Hammie217/OpenSourcePSU/Images/3D.PNG

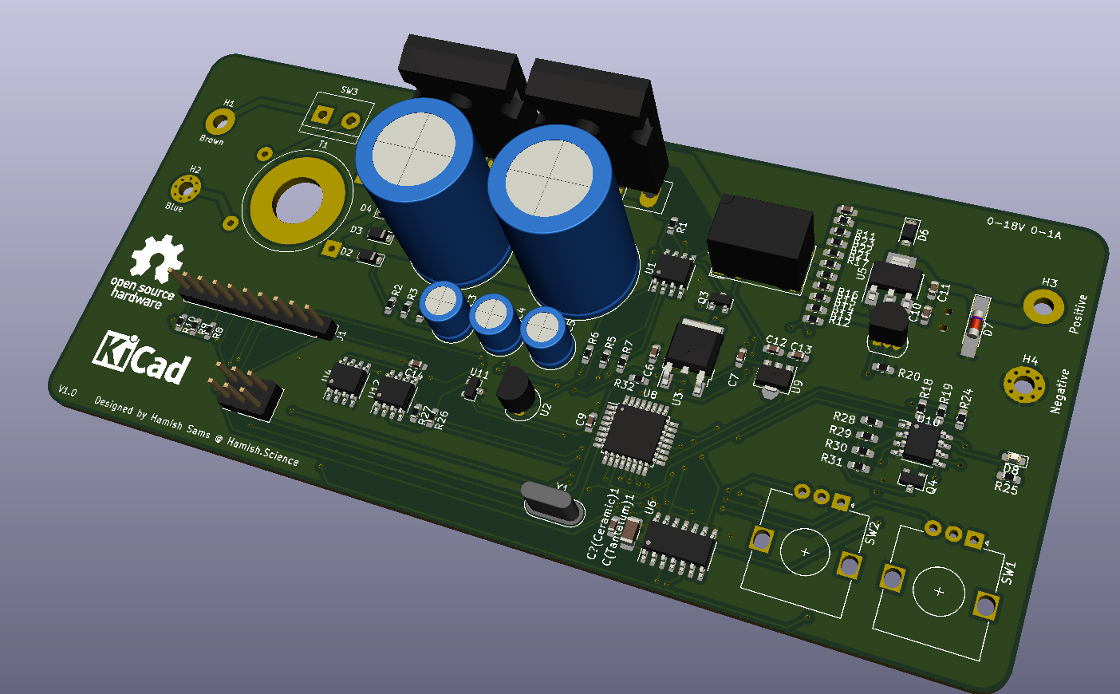
Images/3D.PNG
