Hammie217/OpenSourcePSU/Images/3DBackV2.PNG

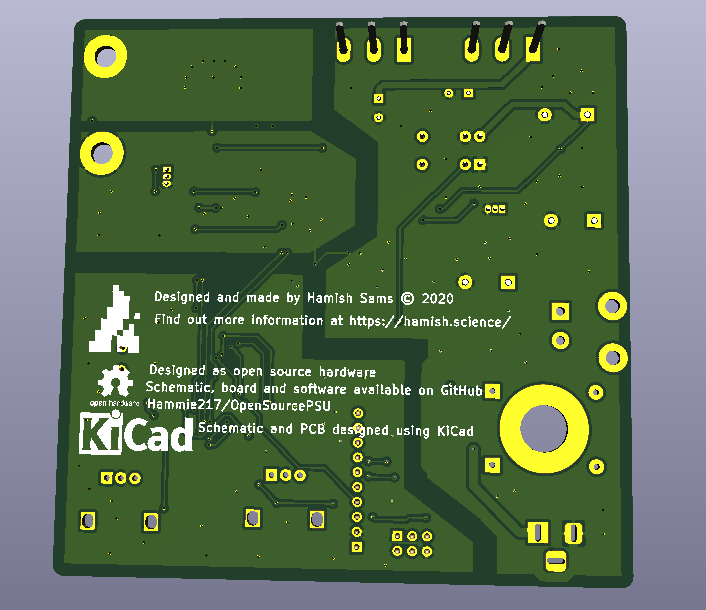
Images/3DBackV2.PNG
