Hammie217/OpenSourcePSU/Images/3DV2.PNG

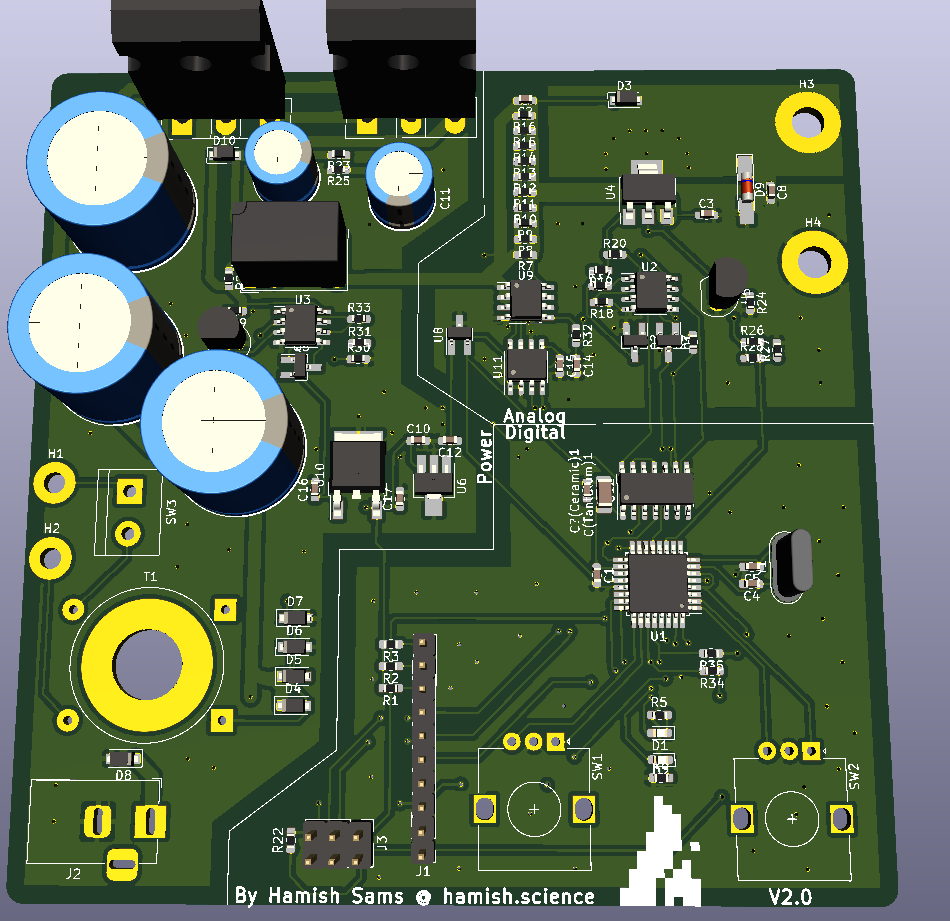
Images/3DV2.PNG
