Hammie217/OpenSourcePSU/Images/Both.PNG

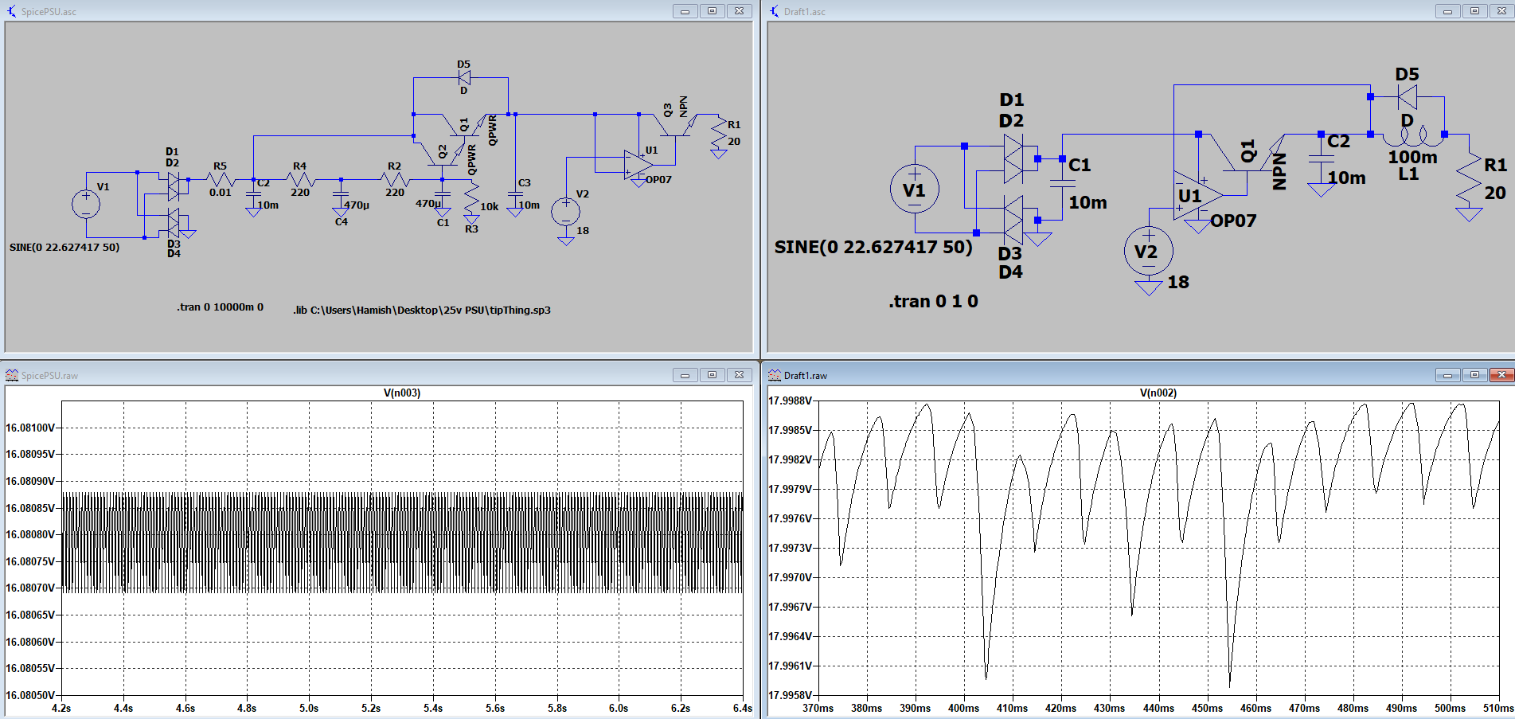
Images/Both.PNG
