Hammie217/OpenSourcePSU/Images/CapMul.PNG

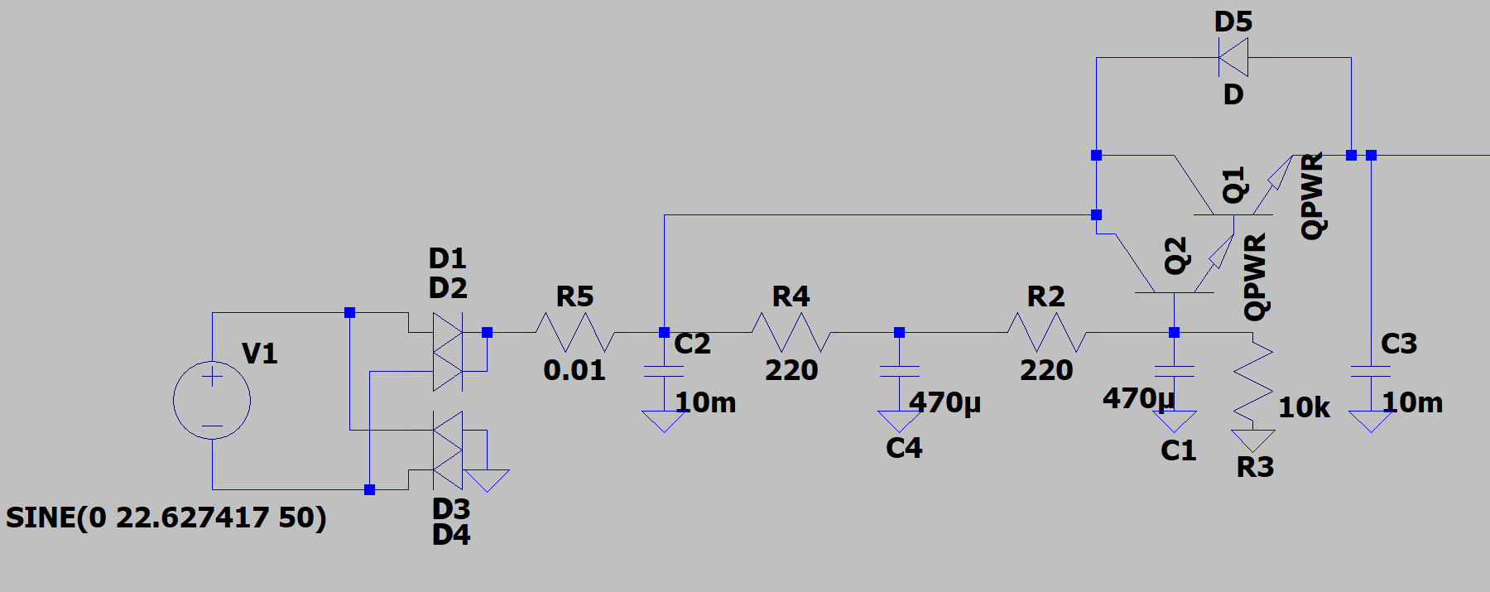
Images/CapMul.PNG
