Hammie217/OpenSourcePSU/Images/CapMulOut.PNG

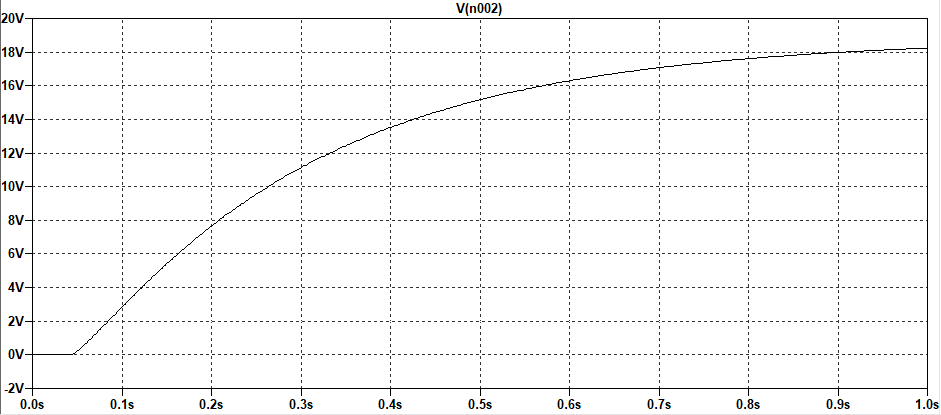
Images/CapMulOut.PNG
