Hammie217/OpenSourcePSU/Images/KicadPSU.PNG

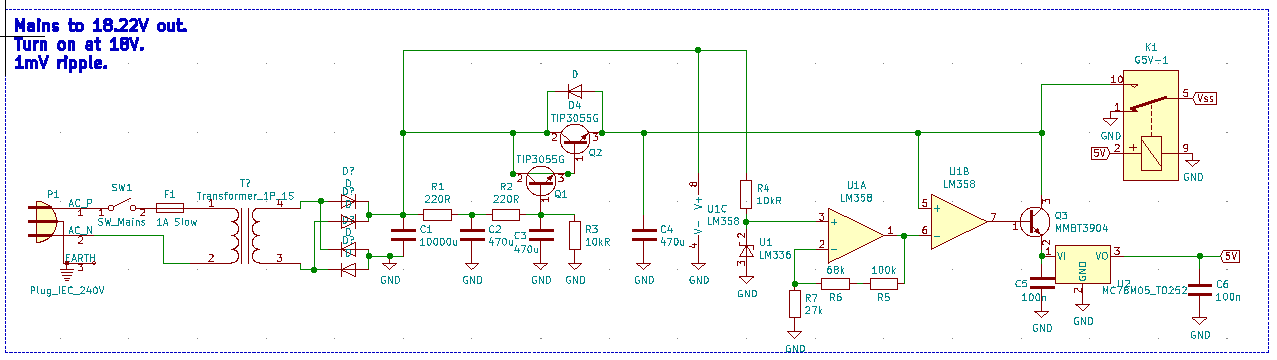
Images/KicadPSU.PNG
