Hammie217/OpenSourcePSU/Images/LinReg.PNG

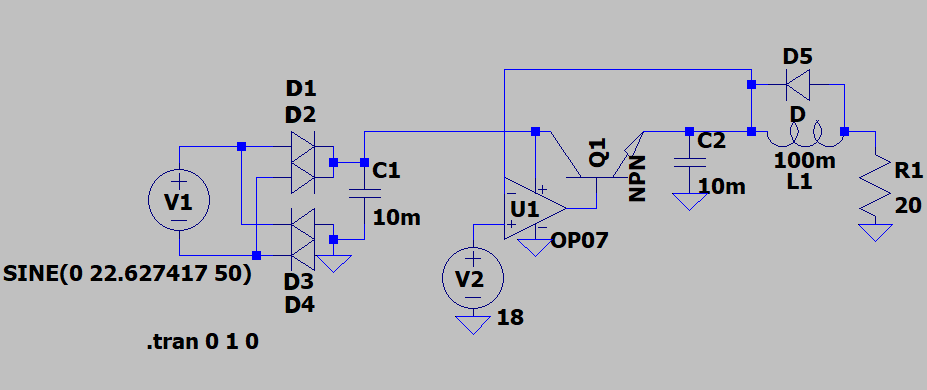
Images/LinReg.PNG
