Hammie217/OpenSourcePSU/Images/LinRegOut.PNG

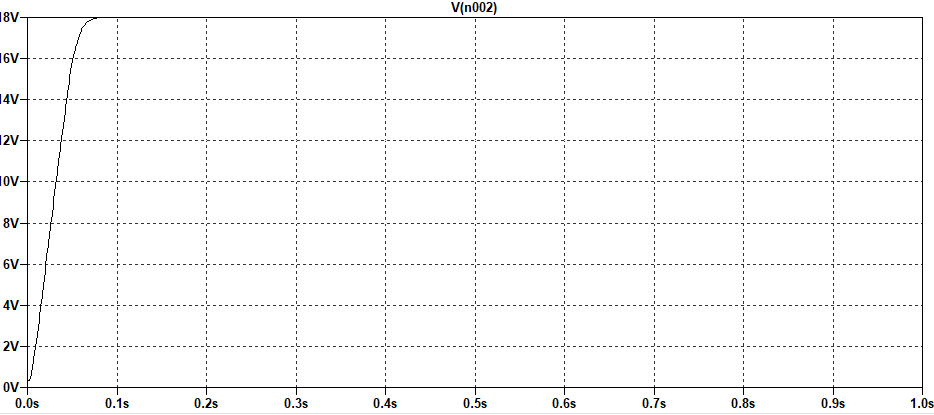
Images/LinRegOut.PNG
