Hammie217/OpenSourcePSU/Images/NotUsingJLC.PNG

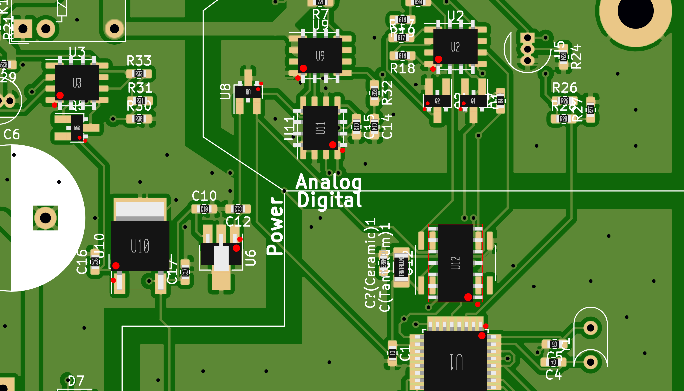
Images/NotUsingJLC.PNG
