Hammie217/OpenSourcePSU/Images/OutputVoltageStageSim.PNG

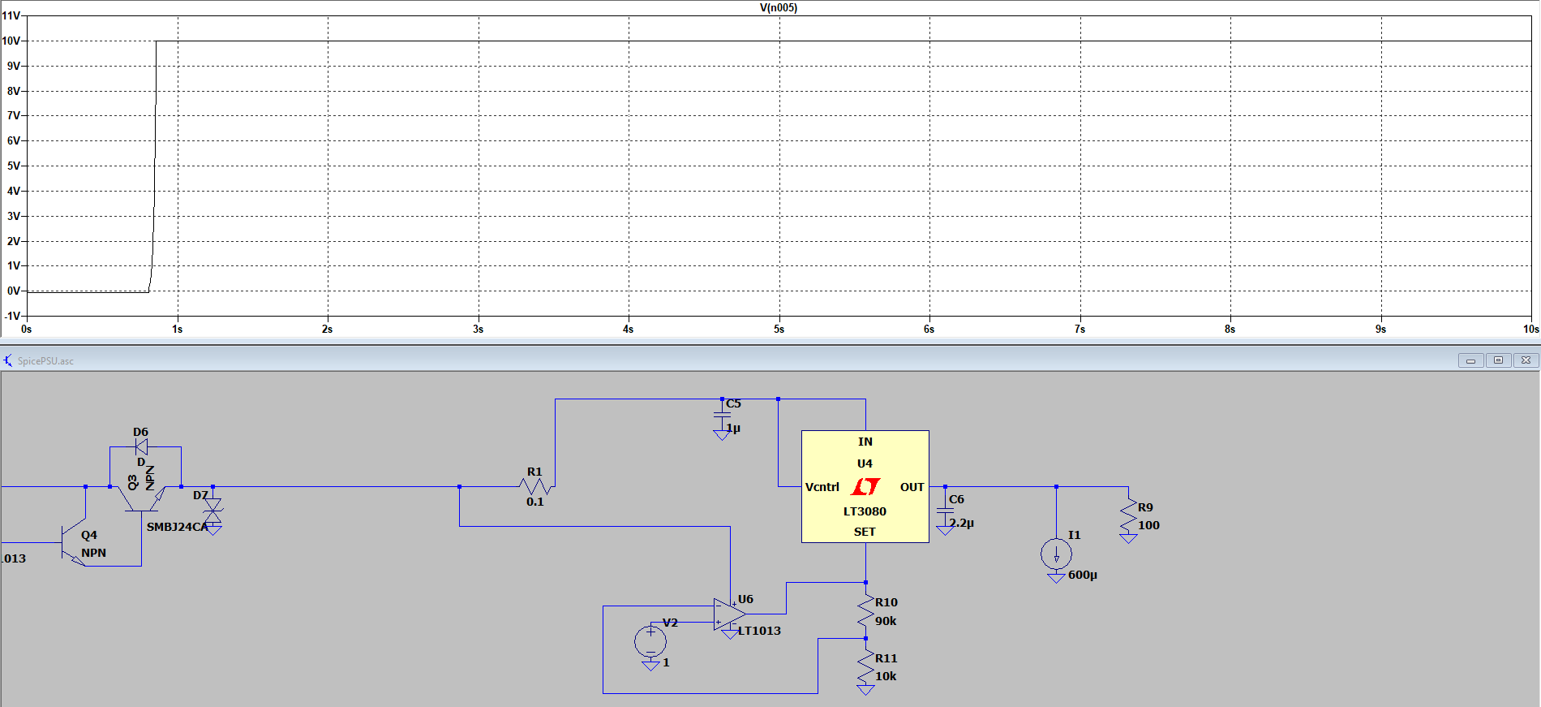
Images/OutputVoltageStageSim.PNG
