Hammie217/OpenSourcePSU/Images/PCB.PNG

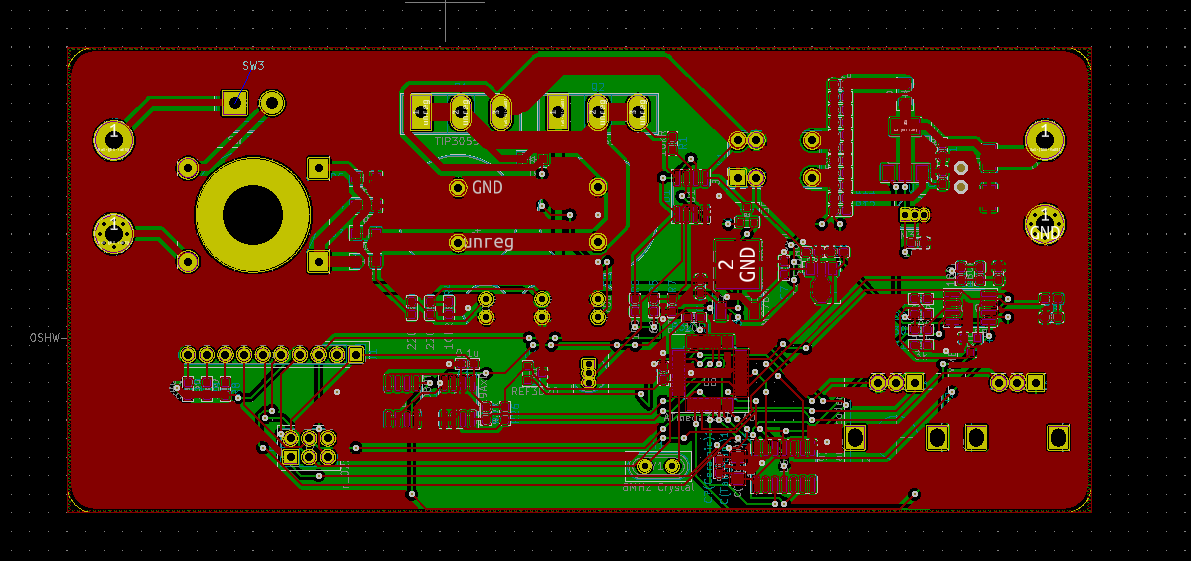
Images/PCB.PNG
