Hammie217/OpenSourcePSU/Images/PCBV2.PNG

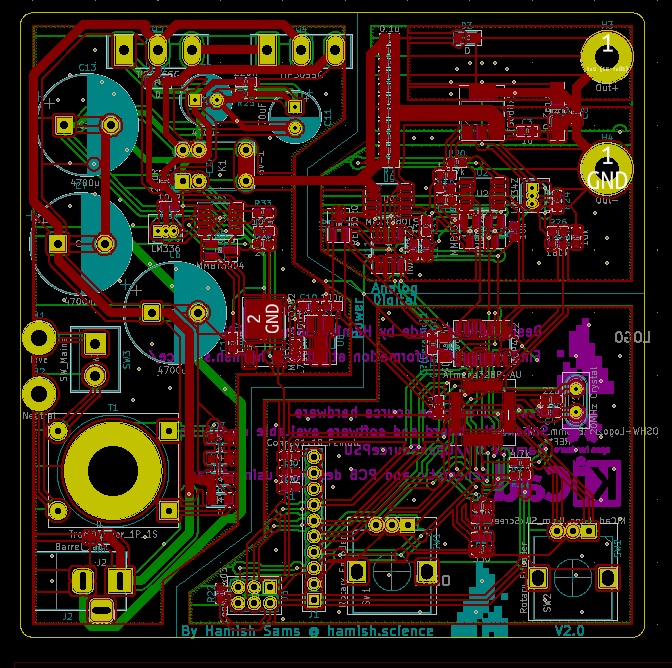
Images/PCBV2.PNG
