Hammie217/OpenSourcePSU/Images/Referenced.PNG

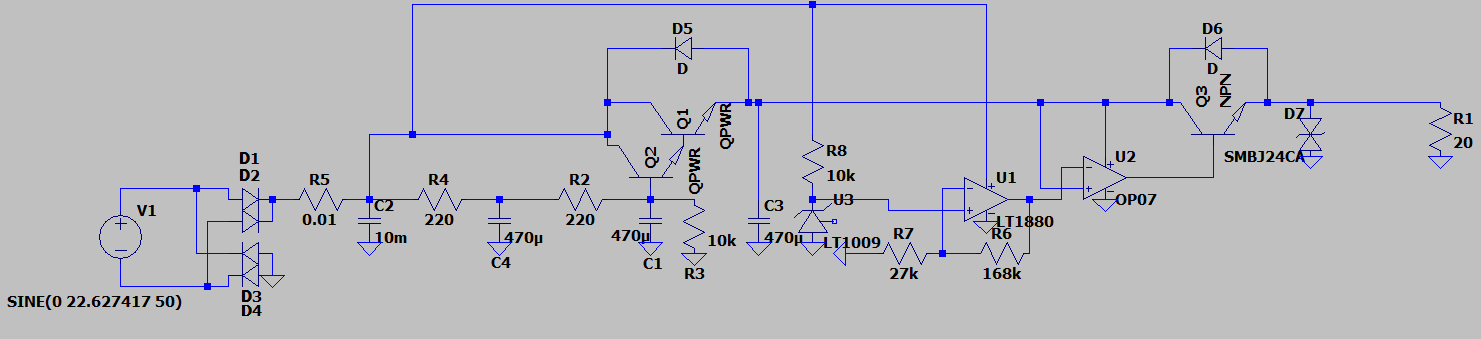
Images/Referenced.PNG
