Hammie217/OpenSourcePSU/Images/SchematicV2.PNG

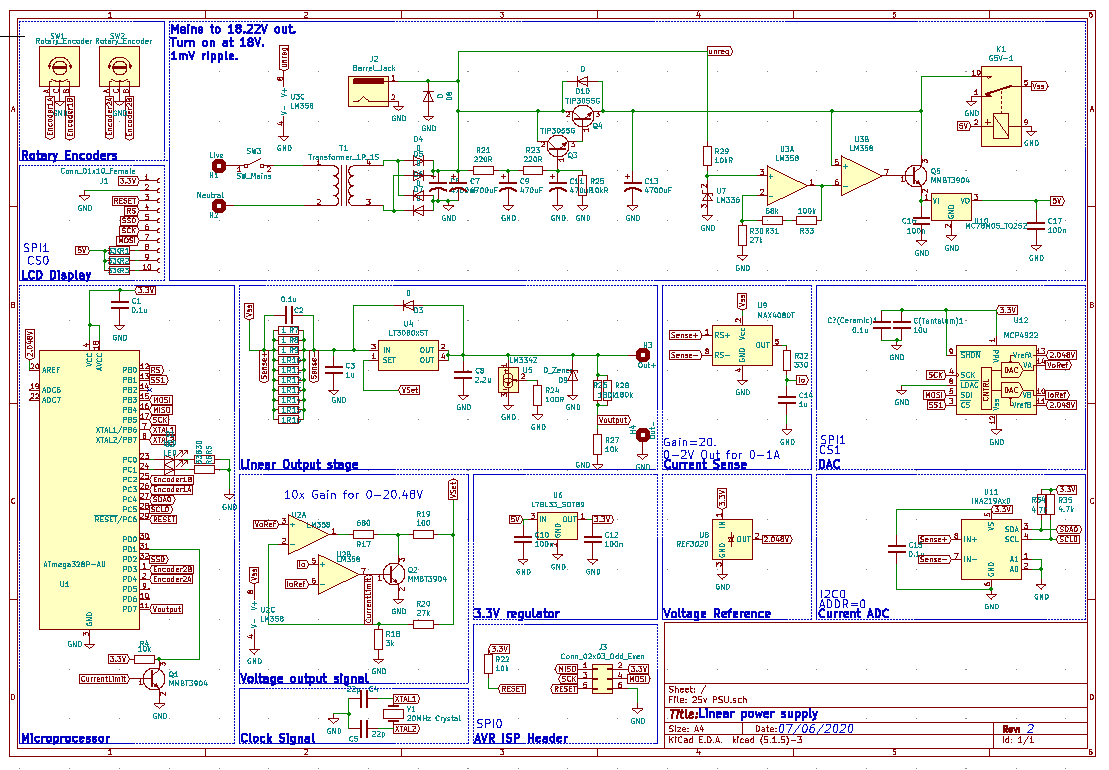
Images/SchematicV2.PNG
