Hammie217/OpenSourcePSU/Images/SwitchedCapMul.PNG

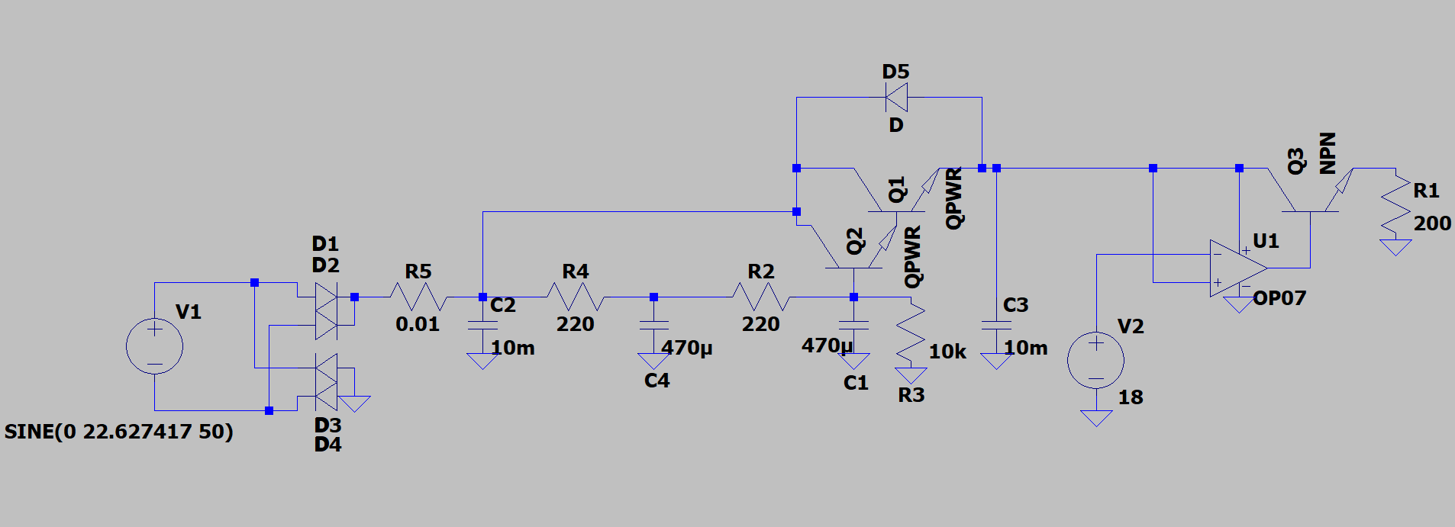
Images/SwitchedCapMul.PNG
