Hammie217/OpenSourcePSU/Images/SwitchedCapMulOut.PNG

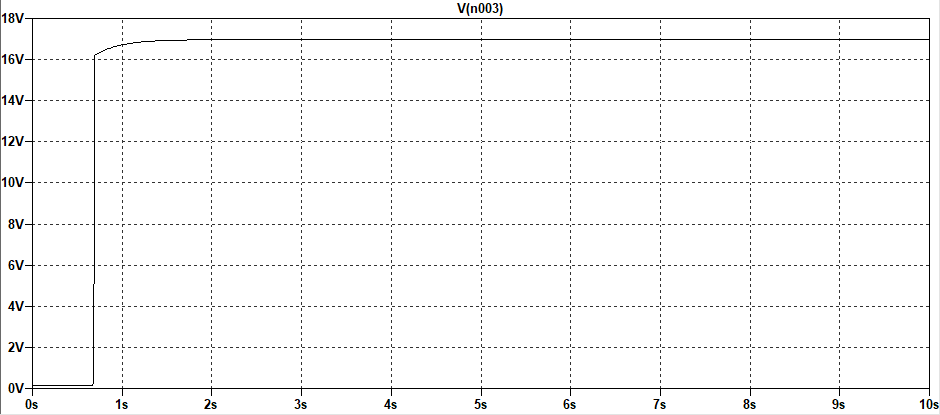
Images/SwitchedCapMulOut.PNG
