Hammie217/OpenSourcePSU/Images/Voltage control stage.PNG

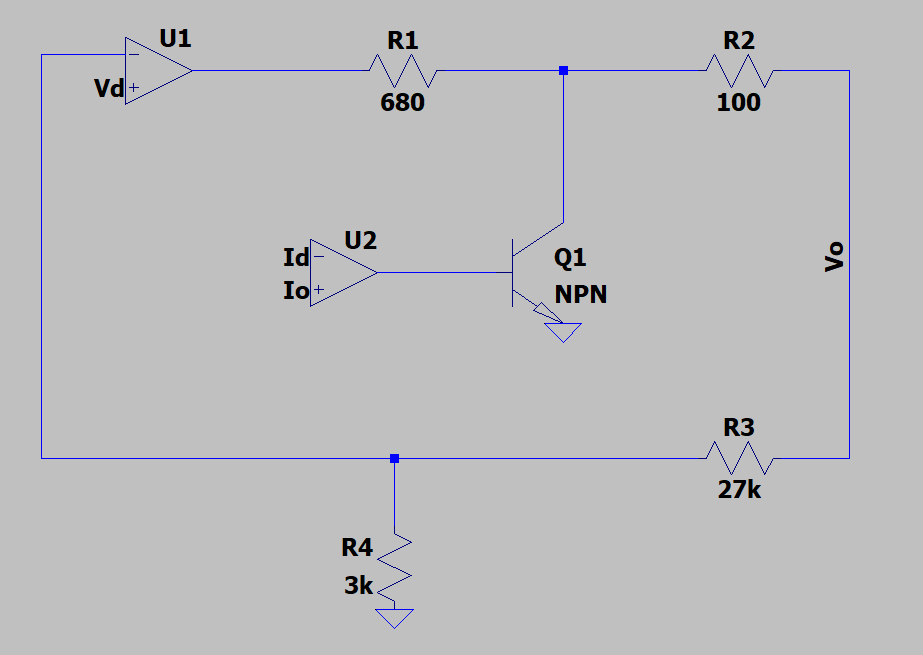
Images/Voltage control stage.PNG
