Hammie217/OpenSourcePSU/Images/voltageSide.PNG

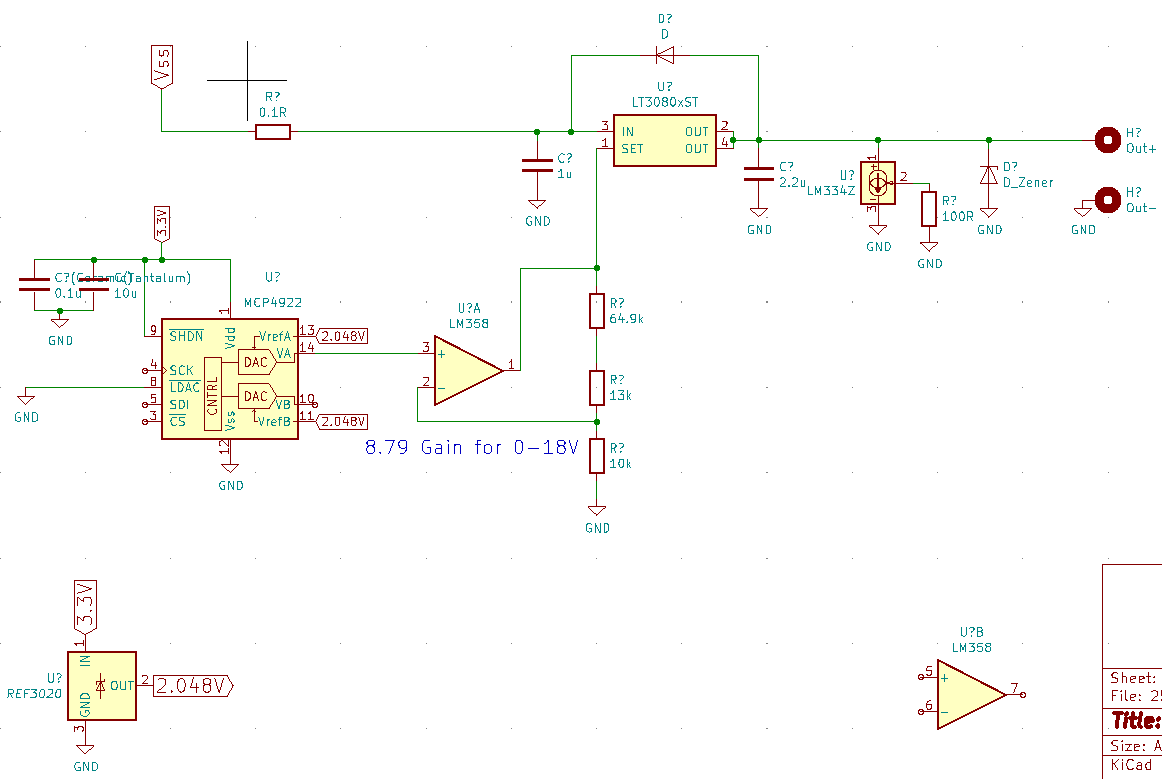
Images/voltageSide.PNG
