Hammie217/OpenSourcePSU/SchematicV1.pdf

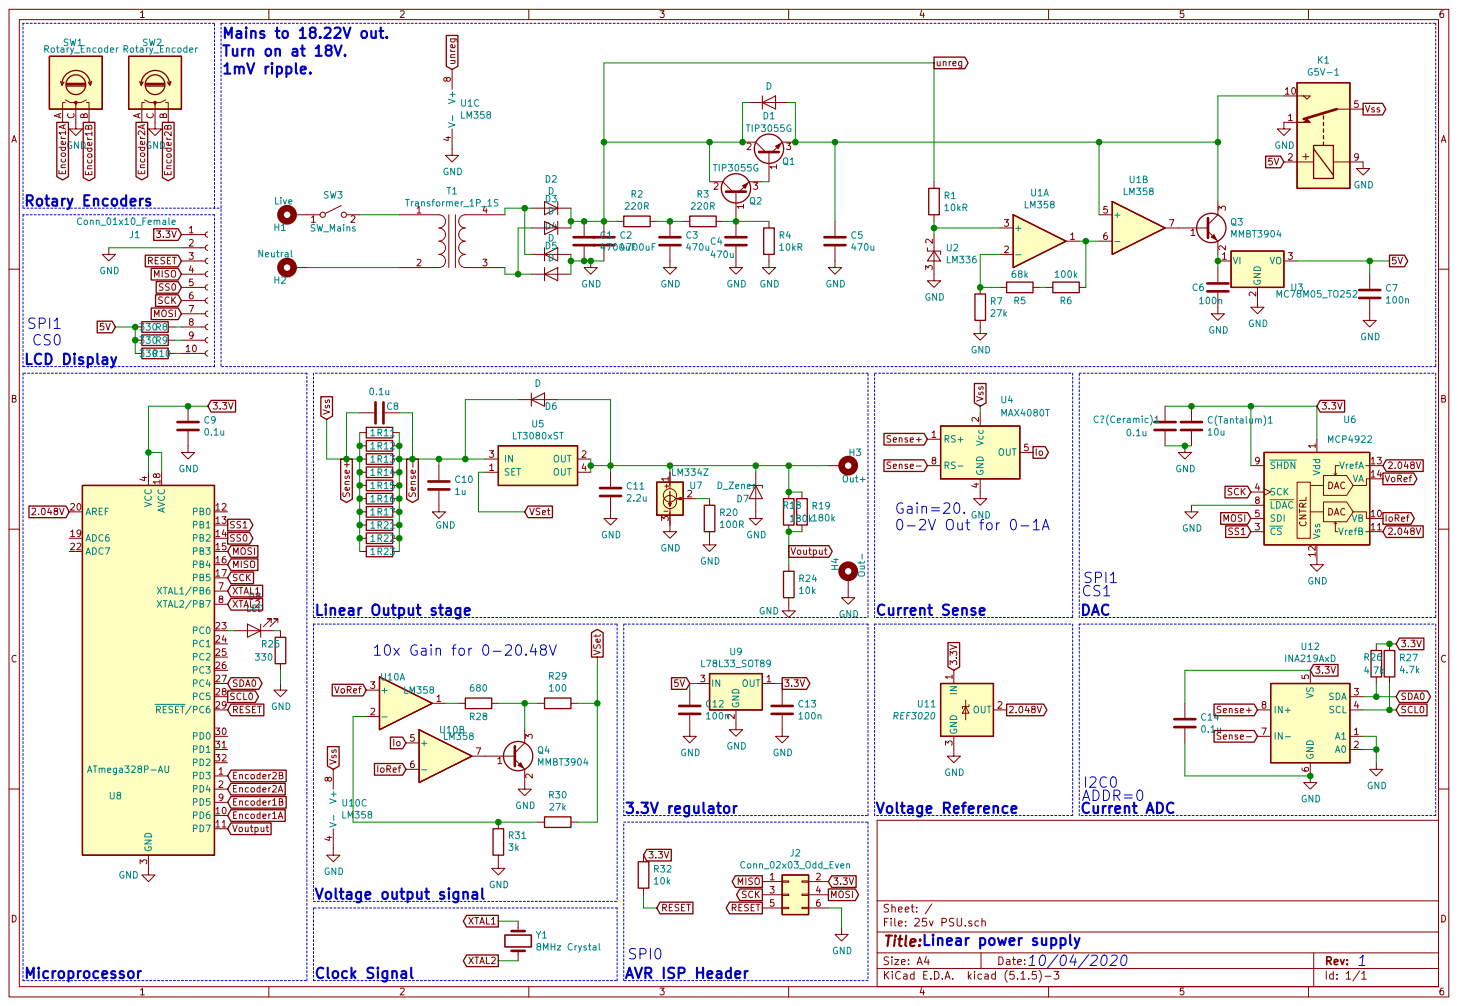
[picture p20: page 1]

4 OUT 5 RS- 8 U4MAX4080T GND GND GND

1 VB 10 VrefB 11 Vss 12 VrefA 13 VA 14 CS 3 SCK 4 SDI 5

Gain=20. Current Sense | SPI1 CS1 DAC

10x Gain for 0-20.48V Voltage output signal | IN 3 U9 100n GND 3.3V regulator | Voltage Reference | ADDR=0 Current ADC | 3.3V

Id: 1/1 Title: File: 25v PSU.sch Sheet: /
Linear power supply

Clock Signal | SPI0

AVR ISP Header
