Hammie217/OpenSourcePSU/OpenPSUV2.pdf

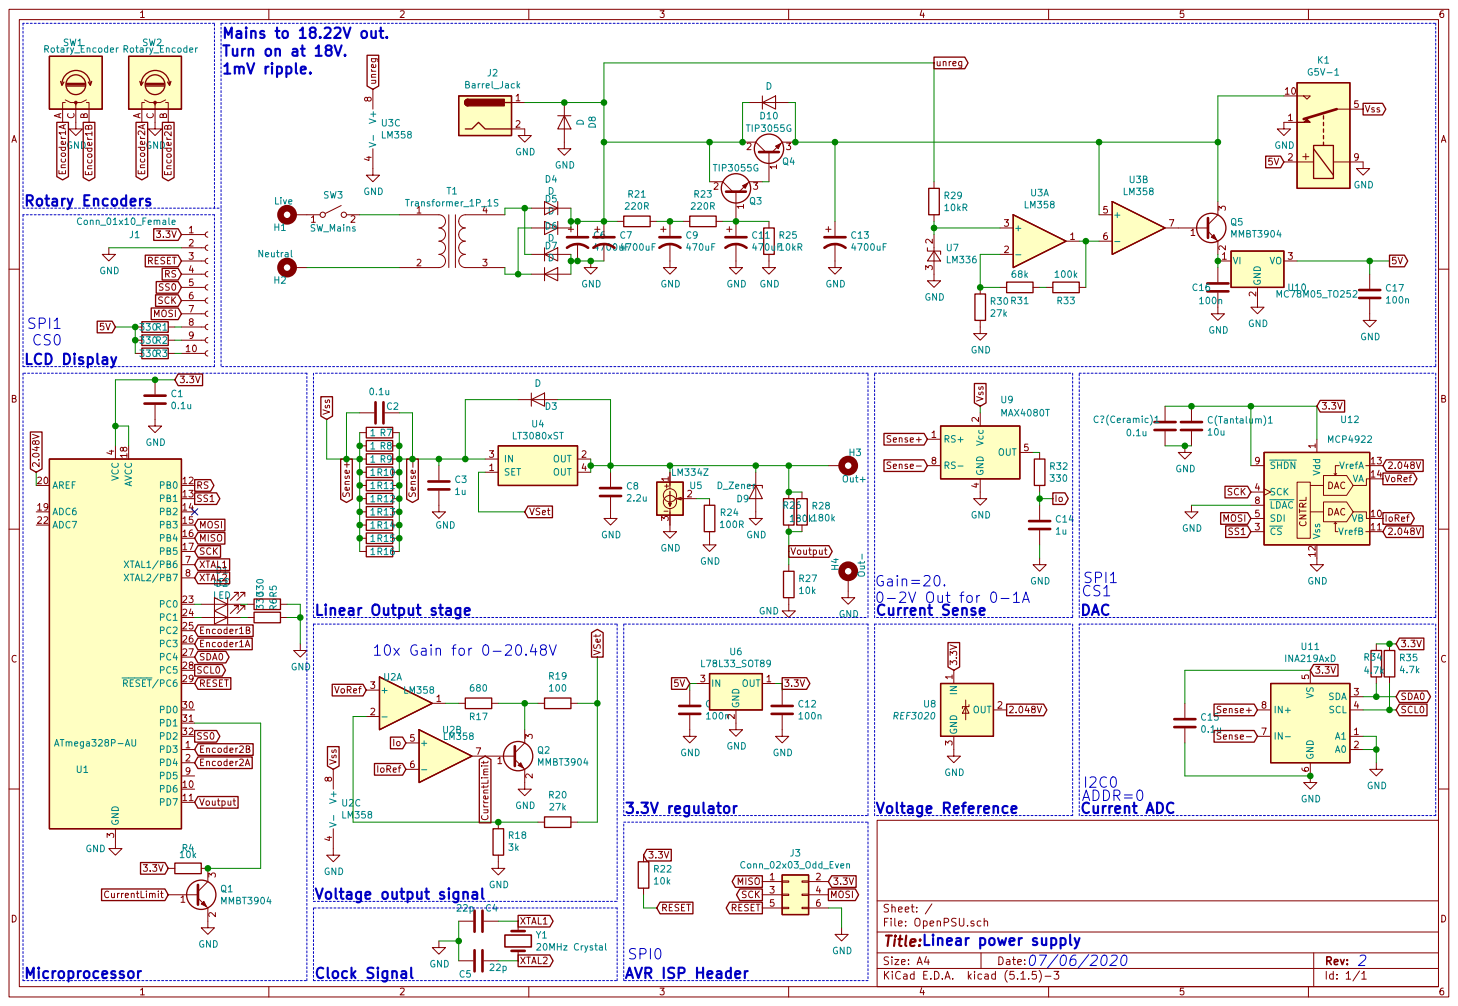
[picture p21: page 1]
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

330C14 Io Gain=20. Current Sense | SPI1 CS1 DAC | | | VoRef 3.3V

10x Gain for 0-20.48V Voltage output signal | IN 3 U6 100n GND 3.3V regulator | GND GND Voltage Reference | ADDR=0 Current ADC

Clock Signal | | SPI0
