Hammie217/OpenSourcePSU/Spice/Draft1.asc

C1: cap; 10m
C2: cap; 10m
D1: diode
D2: diode
D3: diode
D4: diode
D5: diode
L1: ind; 100m
Q1: npn
R1: res; 20
U1: OP07
V1: voltage; SINE(0 22.627417 50)
V2: voltage; 18
Named nets: 0
.tran 0 1 0
