Hammie217/OpenSourcePSU/Spice/SpicePSU.asc

C1: cap; 470µ
C2: cap; 10m
C3: cap; 10m
C4: cap; 470µ
D1: diode
D2: diode
D3: diode
D4: diode
D5: diode
Q1: npn; QPWR
Q2: npn; QPWR
Q3: npn
R1: res; 200
R2: res; 220
R3: res; 10k
R4: res; 220
R5: res; 0.01
U1: OP07
V1: voltage; SINE(0 22.627417 50)
V2: voltage; 18
Named nets: 0
.tran 0 1000m 0
.lib C:\\Users\\Hamish\\Desktop\\25v PSU\\tipThing.sp3
