Hammie217/OpenSourcePSU/Kicad/OpenPSU.kicad_pcb

## KiCad design Kicad/OpenPSU.kicad_pcb (2020-06-08)

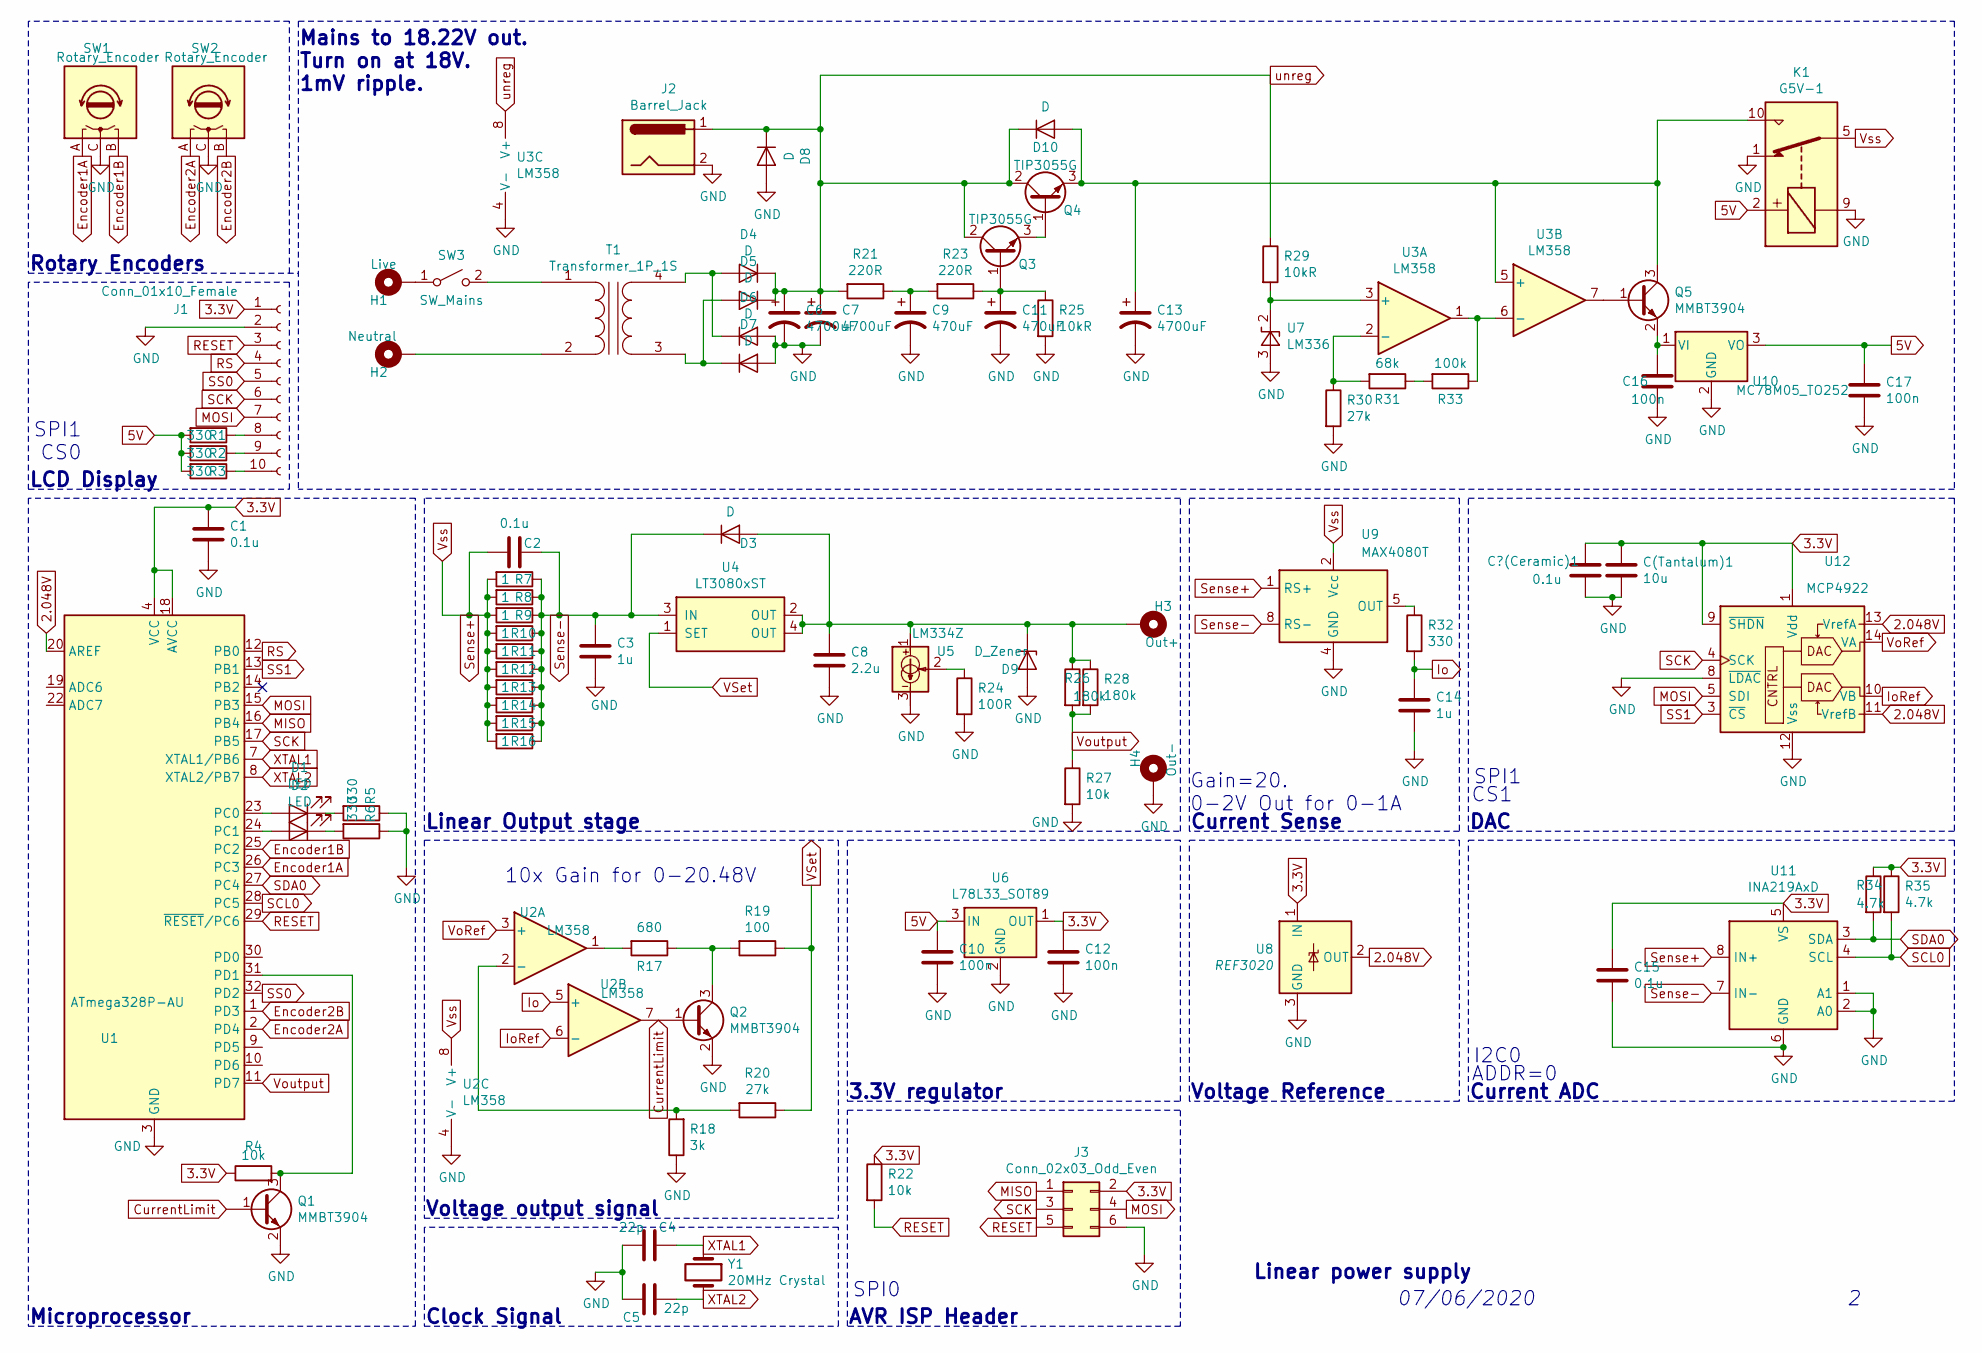
[picture p22: schematic OpenPSU.sch]

Parts:
C1, C2, C15: 0.1u; C_0603_1608Metric_Pad1.05x0.95mm_HandSolder
C3, C14: 1u; C_0603_1608Metric_Pad1.05x0.95mm_HandSolder
C4, C5: 22p; C_0603_1608Metric_Pad1.05x0.95mm_HandSolder
C6, C7, C13: 4700uF; CP_Radial_D16.0mm_P7.50mm
C8: 2.2u; C_0603_1608Metric_Pad1.05x0.95mm_HandSolder
C9, C11: 470uF; CP_Radial_D8.0mm_P3.50mm
C10, C12, C16, C17: 100n; C_0603_1608Metric_Pad1.05x0.95mm_HandSolder
C(Tantalum)1: 10u; C_1206_3216Metric_Pad1.42x1.75mm_HandSolder
C?(Ceramic)1: 0.1u; C_0603_1608Metric_Pad1.05x0.95mm_HandSolder
D1, D2: LED; LED_0603_1608Metric_Pad1.05x0.95mm_HandSolder
D3, D4, D5, D6, D7, D8, D10: D; D_SOD-123F
D9: D_Zener; D_MiniMELF_Handsoldering
H1: Live; MountingHole_2.5mm_Pad
H2: Neutral; MountingHole_2.5mm_Pad
H3: Out+; MountingHole_4mm_Pad
H4: Out-; MountingHole_4mm_Pad
J1: Conn_01x10_Female; PinHeader_1x10_P2.54mm_Vertical
J2: Barrel_Jack; BarrelJack_Horizontal
J3: Conn_02x03_Odd_Even; PinHeader_2x03_P2.54mm_Vertical
K1: G5V-1; Relay_SPDT_Omron_G5V-1
Q1, Q2, Q5: MMBT3904; SOT-23_Handsoldering
Q3, Q4: TIP3055G; TO-247-3_Vertical
R1, R2, R3, R5, R6, R32: 330; R_0603_1608Metric_Pad1.05x0.95mm_HandSolder
R4, R22, R27: 10k; R_0603_1608Metric_Pad1.05x0.95mm_HandSolder
R7, R8, R9, R10, R11, R12, R13, R14, R15, R16: 1; R_0603_1608Metric_Pad1.05x0.95mm_HandSolder
R17: 680; R_0603_1608Metric_Pad1.05x0.95mm_HandSolder
R18: 3k; R_0603_1608Metric_Pad1.05x0.95mm_HandSolder
R19: 100; R_0603_1608Metric_Pad1.05x0.95mm_HandSolder
R20, R30: 27k; R_0603_1608Metric_Pad1.05x0.95mm_HandSolder
R21, R23: 220R; R_0603_1608Metric_Pad1.05x0.95mm_HandSolder
R24: 100R; R_0603_1608Metric_Pad1.05x0.95mm_HandSolder
R25, R29: 10kR; R_0603_1608Metric_Pad1.05x0.95mm_HandSolder
R26, R28: 180k; R_0603_1608Metric_Pad1.05x0.95mm_HandSolder
R31: 68k; R_0603_1608Metric_Pad1.05x0.95mm_HandSolder
R33: 100k; R_0603_1608Metric_Pad1.05x0.95mm_HandSolder
R34, R35: 4.7k; R_0603_1608Metric_Pad1.05x0.95mm_HandSolder
SW1, SW2: Rotary_Encoder; RotaryEncoder_Alps_EC12E_Vertical_H20mm
SW3: SW_Mains; TerminalBlock_bornier-2_P5.08mm
T1: Transformer_1P_1S; Transformer_Toroid_Horizontal_D18.0mm
U1: ATmega328P-AU; TQFP-32_7x7mm_P0.8mm
U2, U3: LM358; SOIC-8_3.9x4.9mm_P1.27mm
U4: LT3080xST; SOT-223
U5: LM334Z; TO-92_Inline
U6: L78L33_SOT89; SOT-89-3_Handsoldering
U7: LM336; TO-92_Inline
U8: REF3020; SOT-23_Handsoldering
U9: MAX4080T; SOIC-8_3.9x4.9mm_P1.27mm
U10: MC78M05_TO252; TO-252-2
U11: INA219AxD; SOIC-8_3.9x4.9mm_P1.27mm
U12: MCP4922; SOIC-14_3.9x8.7mm_P1.27mm
Y1: 20MHz Crystal; Crystal_HC52-8mm_Vertical

Connections:
2.048V: U1.20 (AREF), U8.2 (OUT), U12.11 (VrefB), U12.13 (VrefA)
3.3V: C1.1, C12.1, C15.1, C(Tantalum)1.1, C?(Ceramic)1.1, J1.1, J3.2, R4.1, R22.1, R34.1, R35.1, U1.4 (VCC), U1.6 (VCC), U1.18 (AVCC), U6.1 (OUT), U8.1 (IN), U11.5 (VS), U12.1 (Vdd), U12.9 (~SHDN)
5V: C10.1, C17.1, K1.2, R1.2, R2.2, R3.2, U6.3 (IN), U10.3 (VO)
CurrentLimit: Q1.1 (B), Q2.1 (B), U2.7
Encoder1A: SW1.A, U1.26 (PC3)
Encoder1B: SW1.B, U1.25 (PC2)
Encoder2A: SW2.A, U1.2 (PD4)
Encoder2B: SW2.B, U1.1 (PD3)
GND: C1.2, C3.2, C4.2, C5.2, C6.2, C7.2, C8.2, C9.2, C10.2, C11.2, C12.2, C13.2, C14.2, C15.2, C16.2, C17.2, C(Tantalum)1.2, C?(Ceramic)1.2, D6.2 (A), D7.2 (A), D8.2 (A), D9.2 (A), H4.1, J1.2, J2.2, J3.6, K1.1, K1.9, Q1.2 (E), Q2.2 (E), R5.1, R6.1, R18.1, R24.2, R25.2, R27.2, R30.2, SW1.C, SW2.C, U1.3 (GND), U1.5 (GND), U1.21 (GND), U2.4 (V-), U3.4 (V-), U5.3, U6.2 (GND), U7.3 (A), U8.3 (GND), U9.4 (GND), U10.2 (GND), U11.1 (A1), U11.2 (A0), U11.6 (GND), U12.8 (~LDAC), U12.12 (Vss)
Io: C14.1, R32.2, U2.5 (+)
IoRef: U2.6 (-), U12.10 (VB)
MISO: J3.1, U1.16 (PB4)
MOSI: J1.7, J3.4, U1.15 (PB3), U12.5 (SDI)
unnamed: C8.1, D3.2 (A), D9.1 (K), H3.1, R26.1, R28.1, U4.2 (OUT), U4.4 (OUT), U5.1
unnamed: C9.1, R21.1, R23.2
unnamed: C11.1, Q3.1 (B), R23.1, R25.1
unnamed: C13.1, D10.2 (A), K1.10, Q4.3 (E), Q5.3 (C), U3.5 (+)
unnamed: C16.1, Q5.2 (E), U10.1 (VI)
unnamed: D1.1 (K), R5.2
unnamed: D1.2 (A), U1.23 (PC0)
unnamed: D2.1 (K), R6.2
unnamed: D2.2 (A), U1.24 (PC1)
unnamed: D4.2 (A), D6.1 (K), T1.4 (SB)
unnamed: D5.2 (A), D7.1 (K), T1.3 (SA)
unnamed: H1.1, SW3.1 (A)
unnamed: H2.1, T1.2 (AB)
unnamed: J1.8, R1.1
unnamed: J1.9, R2.1
unnamed: J1.10, R3.1
unnamed: Q1.3 (C), R4.2, U1.31 (PD1)
unnamed: Q2.3 (C), R17.1, R19.2
unnamed: Q3.3 (E), Q4.1 (B)
unnamed: Q5.1 (B), U3.7
unnamed: R17.2, U2.1
unnamed: R18.2, R20.2, U2.2 (-)
unnamed: R24.1, U5.2
unnamed: R29.2, U3.3 (+), U7.2 (K)
unnamed: R30.1, R31.2, U3.2 (-)
unnamed: R31.1, R33.2
unnamed: R32.1, U9.5 (OUT)
unnamed: R33.1, U3.1, U3.6 (-)
unnamed: SW3.2 (B), T1.1 (AA)
RESET: J1.3, J3.5, R22.2, U1.29 (~RESET~/PC6)
RS: J1.4, U1.12 (PB0)
SCK: J1.6, J3.3, U1.17 (PB5), U12.4 (SCK)
SCL0: R35.2, U1.28 (PC5), U11.4 (SCL)
SDA0: R34.2, U1.27 (PC4), U11.3 (SDA)
SS0: J1.5, U1.32 (PD2)
SS1: U1.13 (PB1), U12.3 (~CS)
Sense+: C2.2, K1.5, K1.6, R7.2, R8.2, R9.2, R10.2, R11.2, R12.2, R13.2, R14.2, R15.2, R16.2, U2.8 (V+), U9.1 (RS+), U9.2 (Vcc), U11.8 (IN+)
Sense-: C2.1, C3.1, D3.1 (K), R7.1, R8.1, R9.1, R10.1, R11.1, R12.1, R13.1, R14.1, R15.1, R16.1, U4.3 (IN), U9.8 (RS-), U11.7 (IN-)
VSet: R19.1, R20.1, U4.1 (SET)
VoRef: U2.3 (+), U12.14 (VA)
Voutput: R26.2, R27.1, R28.2, U1.11 (PD7)
XTAL1: C4.1, U1.7 (XTAL1/PB6), Y1.1
XTAL2: C5.1, U1.8 (XTAL2/PB7), Y1.2
unreg: C6.1, C7.1, D4.1 (K), D5.1 (K), D8.1 (K), D10.1 (K), J2.1, Q3.2 (C), Q4.2 (C), R21.2, R29.1, U3.8 (V+)

Notes on the sheet:
10x Gain for 0-20.48V
Mains to 18.22V out. Turn on at 18V. 1mV ripple.
DAC
Current ADC
Gain=20. 0-2V Out for 0-1A
Voltage Reference
Current Sense
Voltage output signal
Linear Output stage
3.3V regulator
AVR ISP Header
Clock Signal
ADDR=0
SPI1
SPI0
Rotary Encoders
SPI1 CS0
CS1
I2C0
LCD Display
Microprocessor
Linear power supply
07/06/2020

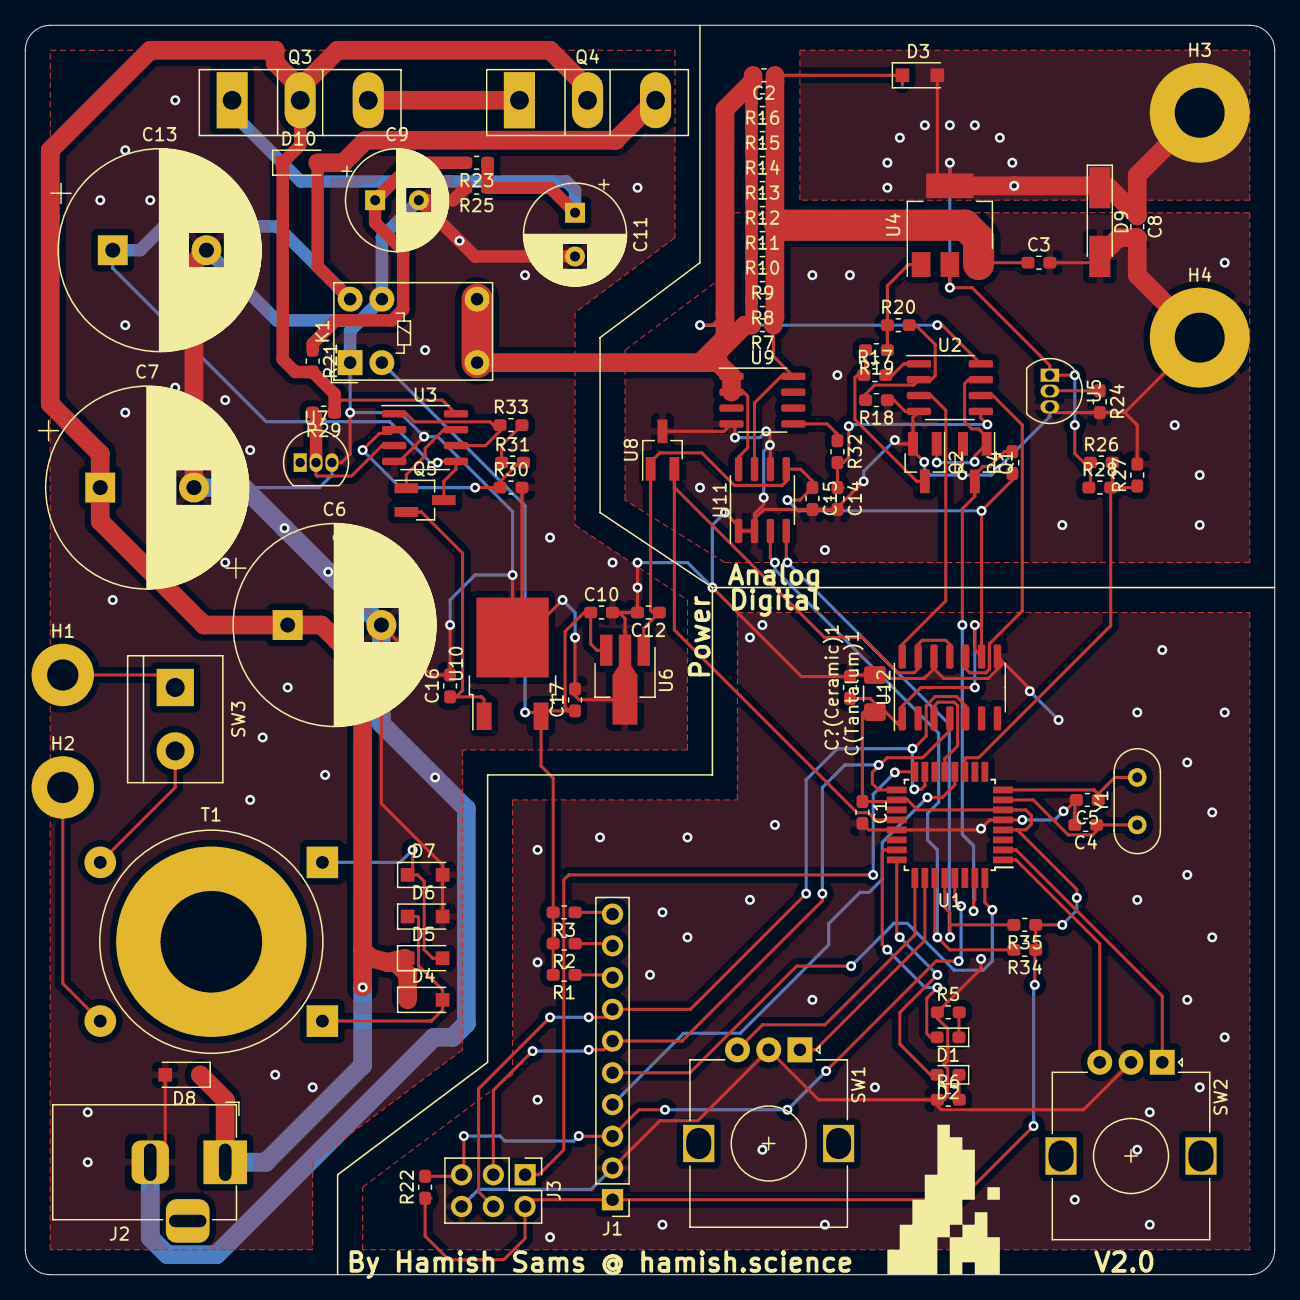
[picture p23: board OpenPSU.kicad_pcb from above]

Board: 2 copper layers, 100.0 x 100.0 mm, 96 parts (1 on the bottom side), 57 nets.

Other parts of the board:
LOGO: LOGO16x16
LOGO#2: LOGO16x16
