Hammie217/OpenSourcePSU/Kicad/PCBV1/25v PSU.kicad_pcb

## KiCad design Kicad/PCBV1/25v PSU.kicad_pcb (2020-04-14)

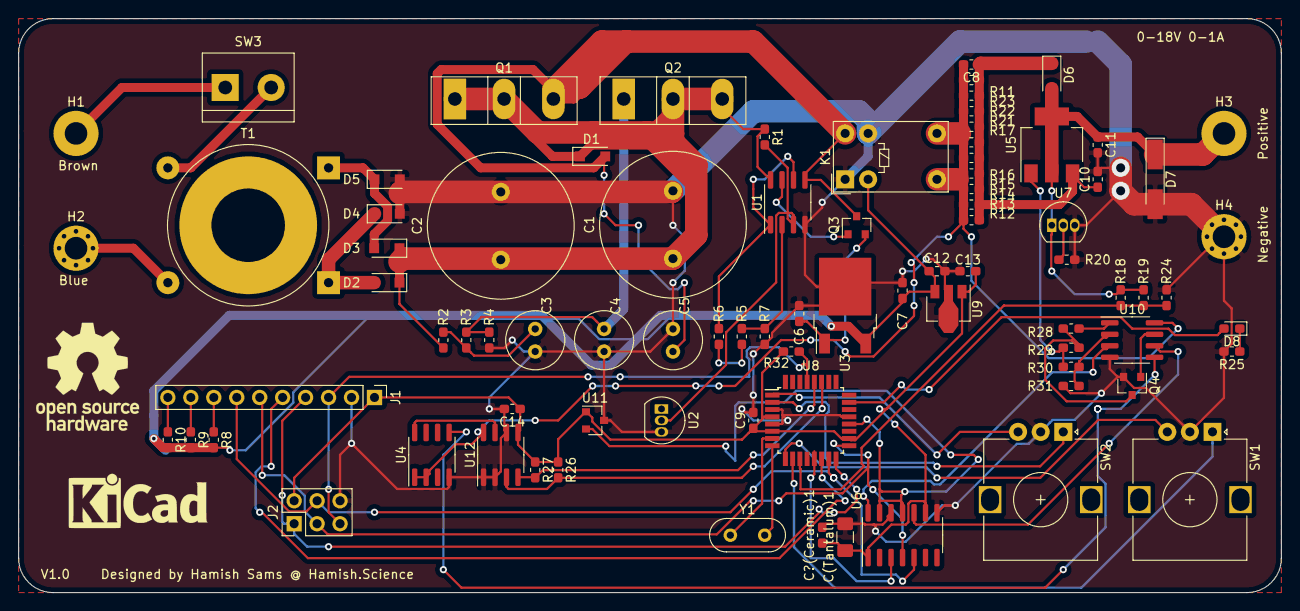
[picture p24: board 25v PSU.kicad_pcb from above]

Board: 2 copper layers, 139.7 x 63.5 mm, 84 parts (0 on the bottom side), 52 nets.

Parts:
C1, C2: 4700uF; C_Radial_D16.0mm_H25.0mm_P7.50mm
C3, C4, C5: 470u; C_Radial_D6.3mm_H7.0mm_P2.50mm
C6, C7, C12, C13: 100n; C_0603_1608Metric_Pad1.05x0.95mm_HandSolder
C8, C9, C14: 0.1u; C_0603_1608Metric_Pad1.05x0.95mm_HandSolder
C10: 1u; C_0603_1608Metric_Pad1.05x0.95mm_HandSolder
C11: 2.2u; C_0603_1608Metric_Pad1.05x0.95mm_HandSolder
C(Tantalum)1: 10u; C_1206_3216Metric_Pad1.42x1.75mm_HandSolder
C?(Ceramic)1: 0.1u; C_0603_1608Metric_Pad1.05x0.95mm_HandSolder
D1, D2, D3, D4, D5, D6: D; D_SOD-123F
D7: D_Zener; D_MiniMELF_Handsoldering
D8: LED; LED_0603_1608Metric_Pad1.05x0.95mm_HandSolder
H1: Live; MountingHole_2.5mm_Pad
H2: Neutral; MountingHole_2.5mm_Pad_Via
H3: Out+; MountingHole_2.5mm_Pad
H4: Out-; MountingHole_2.5mm_Pad_Via
J1: Conn_01x10_Female; PinHeader_1x10_P2.54mm_Vertical
J2: Conn_02x03_Odd_Even; PinHeader_2x03_P2.54mm_Vertical
K1: G5V-1; Relay_SPDT_Omron_G5V-1
Q1, Q2: TIP3055G; TO-247-3_Vertical
Q3, Q4: MMBT3904; SOT-23
R1, R4: 10kR; R_0603_1608Metric_Pad1.05x0.95mm_HandSolder
R2, R3: 220R; R_0603_1608Metric_Pad1.05x0.95mm_HandSolder
R5: 68k; R_0603_1608Metric_Pad1.05x0.95mm_HandSolder
R6: 100k; R_0603_1608Metric_Pad1.05x0.95mm_HandSolder
R7, R30: 27k; R_0603_1608Metric_Pad1.05x0.95mm_HandSolder
R8, R9, R10, R25: 330; R_0603_1608Metric_Pad1.05x0.95mm_HandSolder
R11, R12, R13, R14, R15, R16, R17, R21, R22, R23: 1; R_0603_1608Metric_Pad1.05x0.95mm_HandSolder
R18, R19: 180k; R_0603_1608Metric_Pad1.05x0.95mm_HandSolder
R20: 100R; R_0603_1608Metric_Pad1.05x0.95mm_HandSolder
R24, R32: 10k; R_0603_1608Metric_Pad1.05x0.95mm_HandSolder
R26, R27: 4.7k; R_0603_1608Metric_Pad1.05x0.95mm_HandSolder
R28: 680; R_0603_1608Metric_Pad1.05x0.95mm_HandSolder
R29: 100; R_0603_1608Metric_Pad1.05x0.95mm_HandSolder
R31: 3k; R_0603_1608Metric_Pad1.05x0.95mm_HandSolder
SW1, SW2: Rotary_Encoder; RotaryEncoder_Alps_EC12E_Vertical_H20mm
SW3: SW_Mains; TerminalBlock_bornier-2_P5.08mm
T1: Transformer_1P_1S; Transformer_Toroid_Horizontal_D18.0mm
U1, U10: LM358; SOIC-8_3.9x4.9mm_P1.27mm
U2: LM336; TO-92_Inline
U3: MC78M05_TO252; TO-252-2
U4: MAX4080T; SOIC-8_3.9x4.9mm_P1.27mm
U5: LT3080xST; SOT-223
U6: MCP4922; SOIC-14_3.9x8.7mm_P1.27mm
U7: LM334Z; TO-92_Inline
U8: ATmega328P-AU; TQFP-32_7x7mm_P0.8mm
U9: L78L33_SOT89; SOT-89-3
U11: REF3020; SOT-23
U12: INA219AxD; SOIC-8_3.9x4.9mm_P1.27mm
Y1: 8MHz Crystal; Crystal_HC52-6mm_Vertical

Connections:
2.048V: U6.11, U6.13, U8.20, U11.2
3.3V: C9.1, C13.1, C14.1, C(Tantalum)1.1, C?(Ceramic)1.1, J1.1, J2.2, R26.1, R27.1, R32.1, U6.1, U6.9, U8.4, U8.6, U8.18, U9.1, U11.1, U12.5
5V: C7.1, C12.1, K1.2, R8.2, R9.2, R10.2, U3.3, U9.3
Encoder1A: SW1.A, U8.10
Encoder1B: SW1.B, U8.9
Encoder2A: SW2.A, U8.2
Encoder2B: SW2.B, U8.1
GND: C1.2, C2.2, C3.2, C4.2, C5.2, C6.2, C7.2, C9.2, C10.2, C11.2, C12.2, C13.2, C14.2, C(Tantalum)1.2, C?(Ceramic)1.2, D4.2, D5.2, D7.2, H4.1, J1.2, J2.6, K1.1, K1.9, Q4.2, R4.2, R7.2, R20.2, R24.2, R25.2, R31.1, SW1.C, SW2.C, U1.4, U2.3, U3.2, U4.4, U6.8, U6.12, U7.3, U8.3, U8.5, U8.21, U9.2, U10.4, U11.3, U12.1, U12.2, U12.6
Io: U4.5, U10.5
IoRef: U6.10, U10.6
MISO: J1.4, J2.1, U8.16
MOSI: J1.7, J2.4, U6.5, U8.15
unnamed: C3.1, R2.1, R3.2
unnamed: C4.1, Q2.1, R3.1, R4.1
unnamed: C5.1, D1.2, K1.10, Q1.3, Q3.3, U1.5
unnamed: C6.1, Q3.2, U3.1
unnamed: C8.1, C10.1, D6.1, R11.1, R12.1, R13.1, R14.1, R15.1, R16.1, R17.1, R21.1, R22.1, R23.1, U5.3
unnamed: C11.1, D6.2, D7.1, H3.1, R18.1, R19.1, U5.2, U5.4, U7.1
unnamed: D2.2, D4.1, T1.4
unnamed: D3.2, D5.1, T1.3
unnamed: D8.1, R25.1
unnamed: D8.2, U8.23
unnamed: H1.1, SW3.1
unnamed: H2.1, T1.2
unnamed: J1.8, R8.1
unnamed: J1.9, R9.1
unnamed: J1.10, R10.1
unnamed: Q3.1, U1.7
unnamed: Q4.1, U10.7
unnamed: Q4.3, R28.1, R29.2
unnamed: R1.2, U1.3, U2.2
unnamed: R5.1, R6.2
unnamed: R5.2, R7.1, U1.2
unnamed: R6.1, U1.1, U1.6
unnamed: R20.1, U7.2
unnamed: R28.2, U10.1
unnamed: R30.2, R31.2, U10.2
unnamed: SW3.2, T1.1
RESET: J1.3, J2.5, R32.2, U8.29
SCK: J1.6, J2.3, U6.4, U8.17
SCL0: R27.2, U8.28, U12.4
SDA0: R26.2, U8.27, U12.3
SS0: J1.5, U8.14
SS1: U6.3, U8.13
Sense+: C8.2, K1.5, K1.6, R11.2, R12.2, R13.2, R14.2, R15.2, R16.2, R17.2, R21.2, R22.2, R23.2, U4.1, U4.2, U10.8, U12.8
Sense-: U4.8, U12.7
VSet: R29.1, R30.1, U5.1
VoRef: U6.14, U10.3
Voutput: R18.2, R19.2, R24.1, U8.11
XTAL1: U8.7, Y1.1
XTAL2: U8.8, Y1.2
unreg: C1.1, C2.1, D1.1, D2.1, D3.1, Q1.1, Q1.2, Q2.2, Q2.3, R1.1, R2.2, U1.8
