Hammie217/OpenSourcePSU/(commit log)

2020-04-14 Tidied files
    [25v PSU.csv, 25v PSU.kicad_pcb, 25v PSU.sch]
2020-05-10 untested rotary encoder test
2020-06-07 design updates
    [25v PSU.sch]
2020-06-08 V2 design complete
    [25v PSU-B_Cu.gbr, 25v PSU-B_Mask.gbr, 25v PSU-B_Paste.gbr, 25v PSU-B_SilkS.gbr, 25v PSU-Edge_Cuts.gbr, 25v PSU-F_Cu.gbr, 25v PSU-F_Mask.gbr, 25v PSU-F_Paste.gbr]
