Hammie217/OpenSourcePSU/(notices)

Notices in the files:
Kicad/OpenPSU.kicad_pcb:
Designed and made by Hamish Sams © 2020
